jamvanderloeff/RGB-to-NTSC/README.md

# RGB-to-NTSC
 Converts RGB 15kHz video in the form of VGA or SCART into NTSC and/or PAL composite and s-video using
