jamvanderloeff/RGB-to-NTSC/rgbntsc.pdf

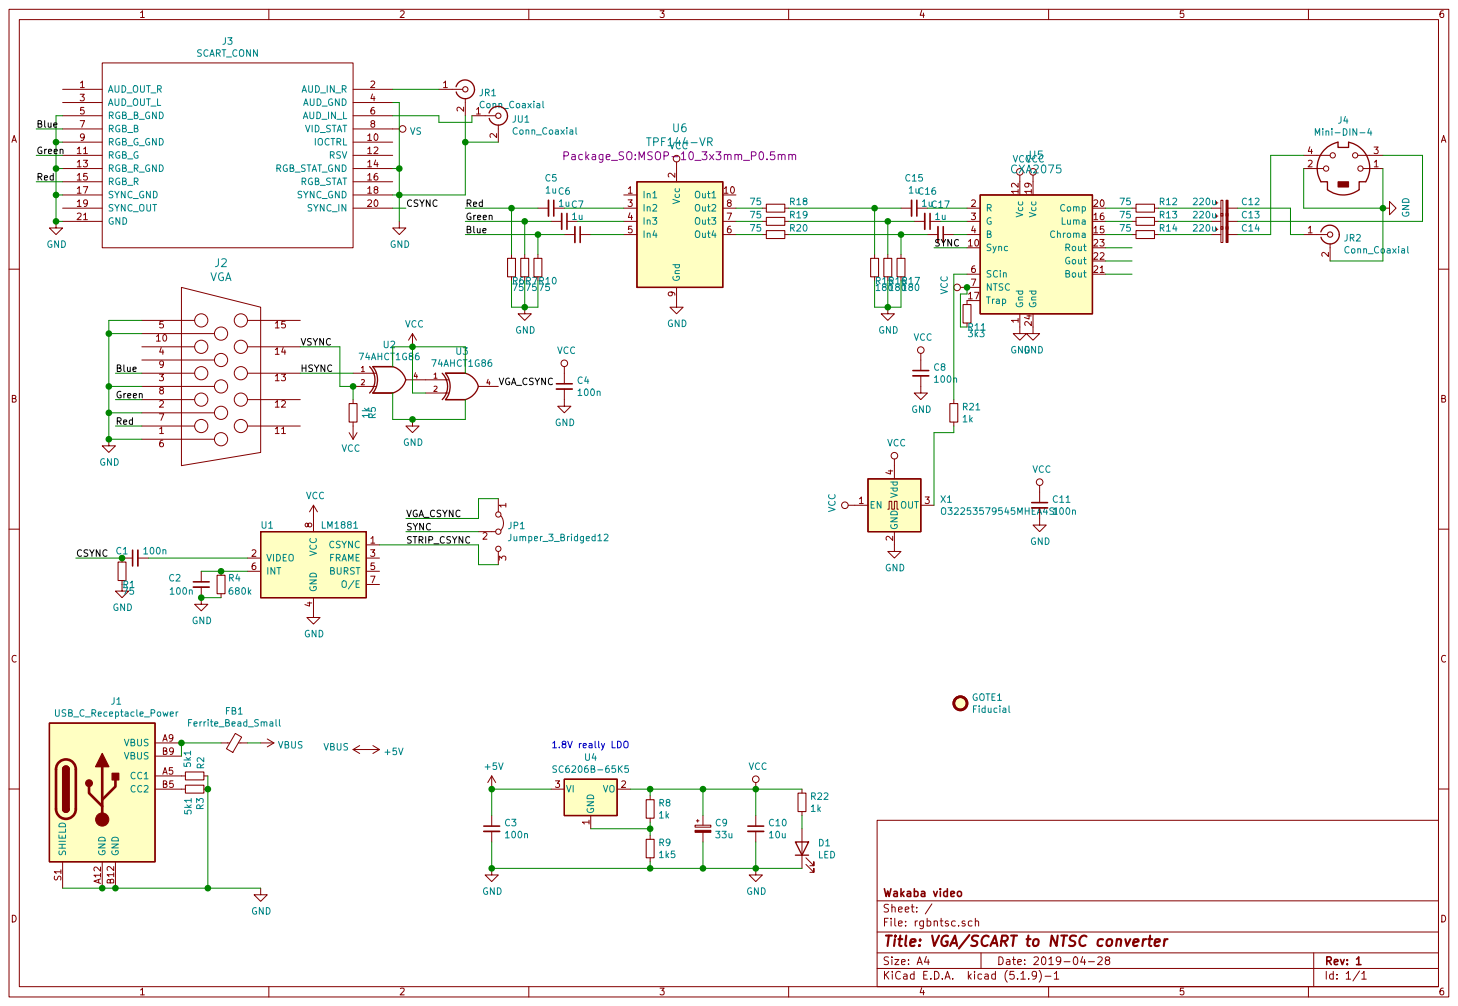
[picture p1: page 1]

File: rgbntsc.sch Sheet: / Wakaba video

Id: 1/1 Title: VGA/SCART to NTSC converter
