jamvanderloeff/RGB-to-NTSC/rgbntsc.kicad_pcb

## KiCad design rgbntsc.kicad_pcb (2025-10-04)

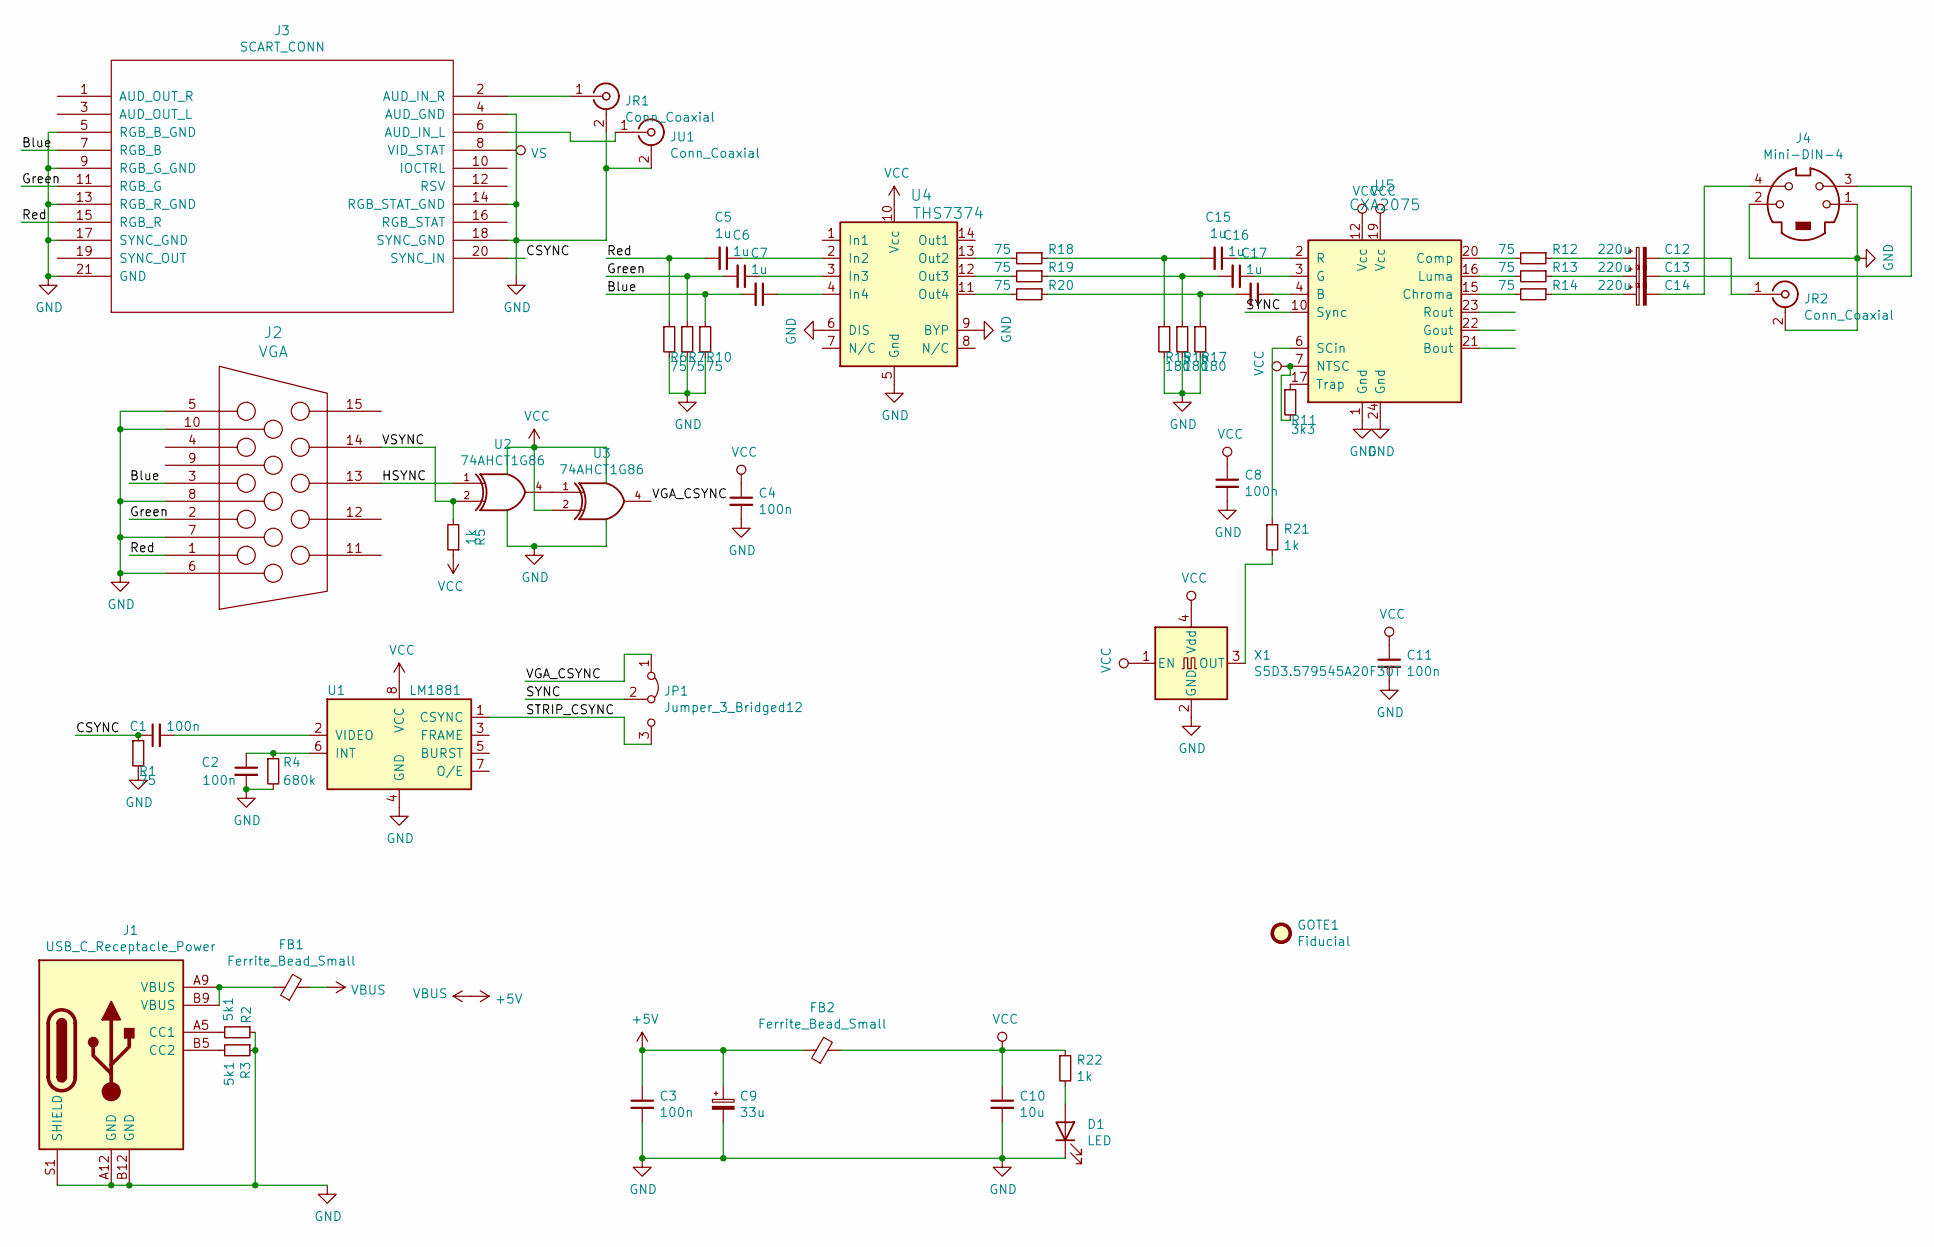
[picture p2: schematic rgbntsc.kicad_sch, VGA/SCART to NTSC converter]

Parts:
C1, C2, C3, C4, C8, C11: 100n; C_0805_2012Metric; LCSC C49678
C5, C6, C7, C15, C16, C17: 1u; C_0805_2012Metric; LCSC C28323
C9: 33u; CP_Elec_6.3x7.7; LCSC C127970
C10: 10u; C_0805_2012Metric; LCSC C15850
C12, C13, C14: 220u; CP_Elec_6.3x5.4; LCSC NOT FITTED
D1: LED; LED_0805_2012Metric; LCSC C34499
FB1, FB2: Ferrite_Bead_Small; C_0805_2012Metric; LCSC C1017
GOTE1: Fiducial; uwuriel; LCSC NOT FITTED
J1: USB_C_Receptacle_Power; USB_C_Receptacle_Generic_Power_Only; LCSC NOT FITTED
J2: VGA; VGA_CONN; LCSC NOT FITTED
J3: SCART_CONN; LCSC NOT FITTED
J4: Mini-DIN-4; CUI_MD-40SM; LCSC NOT FITTED
JP1: Jumper_3_Bridged12; SolderJumper-3_P1.3mm_Bridged12_Pad1.0x1.5mm; LCSC NOT FITTED
JR1, JR2: Conn_Coaxial; Cheapo_RCA_single_edge; LCSC NOT FITTED
JU1: Conn_Coaxial; Cheapo_RCA_single_edge; LCSC NOT FITTED
R1, R6, R7, R10, R12, R13, R14, R18, R19, R20: 75; R_0805_2012Metric; LCSC C20638
R2, R3: 5k1; R_0805_2012Metric; LCSC C27834
R4: 680k; R_0805_2012Metric; LCSC C17797
R5, R21, R22: 1k; R_0805_2012Metric; LCSC C17513
R11: 3k3; R_0805_2012Metric; LCSC C26010
R15, R16, R17: 180; R_0805_2012Metric; LCSC C25270
U1: LM1881; SOIC-8_3.9x4.9mm_P1.27mm; LCSC NOT FITTED
U2, U3: 74AHCT1G86; SOT-23-5; LCSC C43417
U4: THS7374; TSSOP-14_4.4x5mm_P0.65mm
U5: CXA2075; SO-24_5.3x15mm_P1.27mm; LCSC NOT FITTED
X1: S5D3.579545A20F30T; Oscillator_SMD_EuroQuartz_XO53-4Pin_5.0x3.2mm; LCSC C387187

Connections:
+5V: C3.1, C9.1, FB1.2, FB2.1
/Blue: C7.2, J2.3 (BLUE), J3.7 (RGB_B), R10.1
/CSYNC: C1.1, J3.20 (SYNC_IN), R1.1
/Green: C6.2, J2.2 (GREEN), J3.11 (RGB_G), R7.1
/HSYNC: J2.13 (HSYNC), U2.1
/Red: C5.2, J2.1 (RED), J3.15 (RGB_R), R6.1
/STRIP_CSYNC: JP1.3 (B), U1.1 (CSYNC)
/SYNC: JP1.2 (C), U5.10 (Sync)
/VGA_CSYNC: JP1.1 (A), U3.4
/VSYNC: J2.14 (VSYNC), R5.2, U2.2
GND: C2.2, C3.2, C4.2, C8.2, C9.2, C10.2, C11.2, D1.1 (K), J1.A12 (GND), J1.B12 (GND), J1.S1 (SHIELD), J2.5 (GND_HSYNC), J2.6 (RED_RTN), J2.7 (GREEN_RTN), J2.8 (BLUE_RTN), J2.10 (GND_VSYNC), J3.4 (AUD_GND), J3.5 (RGB_B_GND), J3.9 (RGB_G_GND), J3.13 (RGB_R_GND), J3.14 (RGB_STAT_GND), J3.17 (SYNC_GND), J3.18 (SYNC_GND), J3.21 (GND), J4.1, J4.2, JR1.2 (Ext), JR2.2 (Ext), JU1.2 (Ext), R1.2, R2.1, R3.1, R4.2, R6.2, R7.2, R10.2, R15.2, R16.2, R17.2, U1.4 (GND), U2.3 (GND), U3.3 (GND), U4.5 (Gnd), U4.6 (DIS), U4.9 (BYP), U5.1 (Gnd), U5.24 (Gnd), X1.2 (GND)
unnamed: C12.1, R12.1
unnamed: C13.1, R13.1
unnamed: C13.2, J4.3
unnamed: C14.1, R14.1
unnamed: C14.2, J4.4
unnamed: C15.2, R15.1, R18.1
unnamed: C16.2, R16.1, R19.1
unnamed: C17.2, R17.1, R20.1
unnamed: D1.2 (A), R22.2
unnamed: FB1.1, J1.A9 (VBUS), J1.B9 (VBUS)
unnamed: J1.A5 (CC1), R2.2
unnamed: J1.B5 (CC2), R3.2
unnamed: J3.6 (AUD_IN_L), JU1.1 (In)
unnamed: J3.2 (AUD_IN_R), JR1.1 (In)
unnamed: C12.2, JR2.1 (In)
unnamed: C2.1, R4.1, U1.6 (INT)
unnamed: C1.2, U1.2 (VIDEO)
unnamed: U2.4, U3.1
unnamed: C5.1, U4.2 (In2)
unnamed: C6.1, U4.3 (In3)
unnamed: C7.1, U4.4 (In4)
unnamed: R18.2, U4.13 (Out2)
unnamed: R19.2, U4.12 (Out3)
unnamed: R20.2, U4.11 (Out4)
unnamed: C17.1, U5.4 (B)
unnamed: R14.2, U5.15 (Chroma)
unnamed: R12.2, U5.20 (Comp)
unnamed: C16.1, U5.3 (G)
unnamed: R13.2, U5.16 (Luma)
unnamed: C15.1, U5.2 (R)
unnamed: R21.1, U5.6 (SCin)
unnamed: R11.1, U5.17 (Trap)
unnamed: R21.2, X1.3 (OUT)
VCC: C4.1, C8.1, C10.1, C11.1, FB2.2, R5.1, R11.2, R22.1, U1.8 (VCC), U2.5 (VCC), U3.2, U3.5 (VCC), U4.10 (Vcc), U5.7 (NTSC), U5.12 (Vcc), U5.19 (Vcc), X1.1 (EN), X1.4 (Vdd)
VS: J3.8 (VID_STAT)

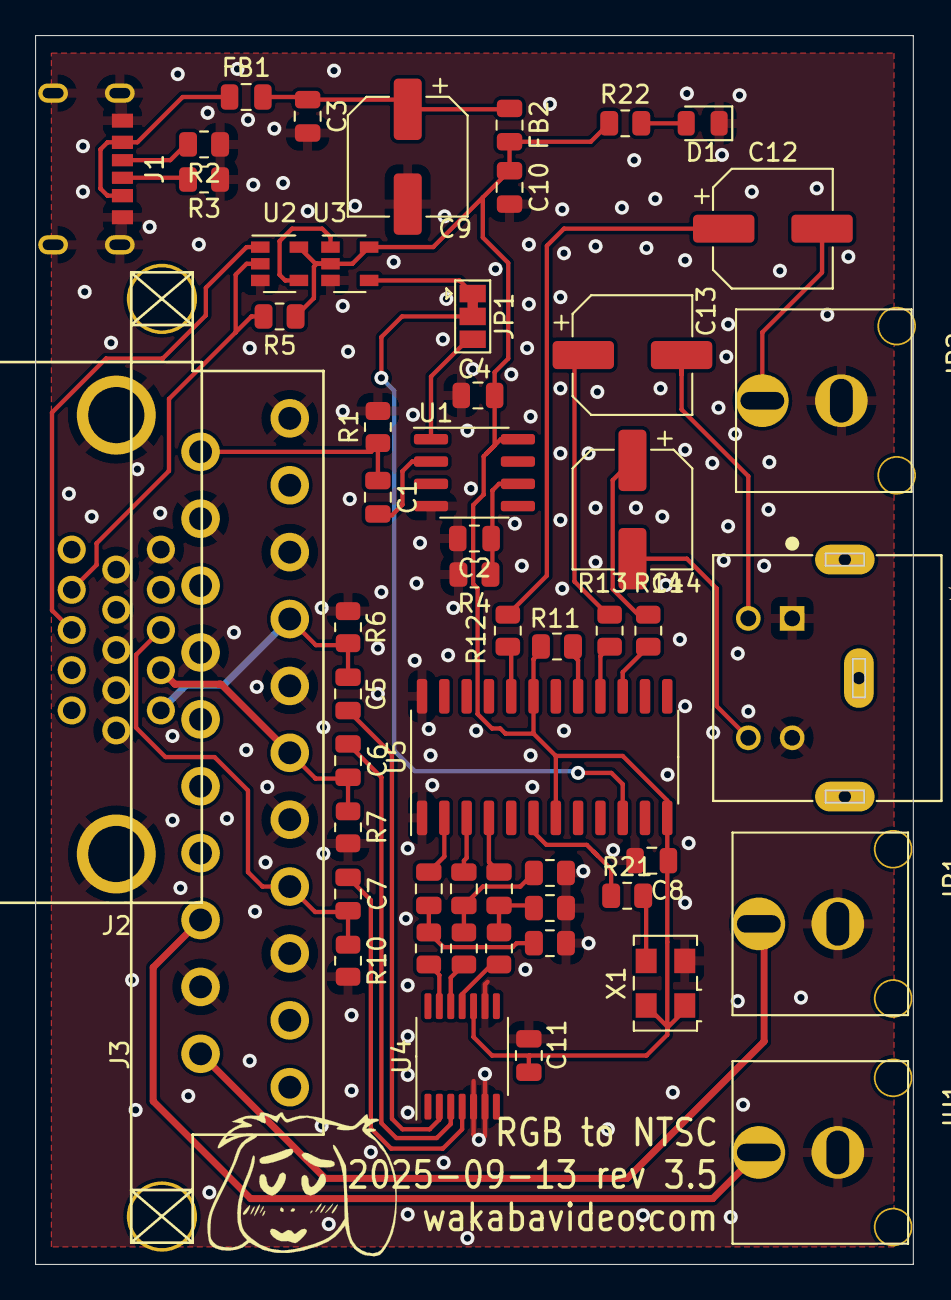
[picture p3: board rgbntsc.kicad_pcb from above]

Board: 2 copper layers, 50.0 x 70.0 mm, 55 parts (0 on the bottom side), 45 nets.
