jamvanderloeff/RGB-to-NTSC/(commit log)

2020-08-23 bit of cleanup and on github now woo
    [covers.kicad_pcb, rgbntsc.kicad_pcb, rgbntsc.sch]
2020-08-23 cleanup and pdfs/gerbs
    [rgbntsc-B_Cu.gbr, rgbntsc-B_Mask.gbr, rgbntsc-B_Paste.gbr, rgbntsc-B_SilkS.gbr, rgbntsc-Edge_Cuts.gbr, rgbntsc-F_Cu.gbr, rgbntsc-F_Mask.gbr, rgbntsc-F_Paste.gbr]
2020-11-21 CXA2075
    Replaces AD724 with CXA2075, also adds GBS compatible RGB out header
    [rgbntsc-B_Cu.gbr, rgbntsc-B_Mask.gbr, rgbntsc-B_Paste.gbr, rgbntsc-B_SilkS.gbr, rgbntsc-Edge_Cuts.gbr, rgbntsc-F_Cu.gbr, rgbntsc-F_Mask.gbr, rgbntsc-F_Paste.gbr]
2020-12-19 added 1v amp and output caps
    [rgbntsc-B_Cu.gbr, rgbntsc-B_Mask.gbr, rgbntsc-B_Paste.gbr, rgbntsc-B_SilkS.gbr, rgbntsc-Edge_Cuts.gbr, rgbntsc-F_Cu.gbr, rgbntsc-F_Mask.gbr, rgbntsc-F_Paste.gbr]
2020-12-28 corrected components
    [rgbntsc.kicad_pcb, rgbntsc.sch]
2021-06-18 add power LED, general tweakage
    [rgbntsc-B_Cu.gbr, rgbntsc-B_Mask.gbr, rgbntsc-B_Paste.gbr, rgbntsc-B_SilkS.gbr, rgbntsc-Edge_Cuts.gbr, rgbntsc-F_Cu.gbr, rgbntsc-F_Mask.gbr, rgbntsc-F_Paste.gbr]
2021-07-08 fix regulator resistor, add schematic pdf
    [rgbntsc.kicad_pcb, rgbntsc.sch]
2021-09-23 add cover
    [covers-B_Cu.gbr, covers-B_Mask.gbr, covers-B_SilkS.gbr, covers-Edge_Cuts.gbr, covers-F_Cu.gbr, covers-F_Mask.gbr, covers-F_SilkS.gbr, covers-NPTH.drl]
2021-11-15 ditched supply reg, just filter harder
    [rgbntsc.kicad_pcb, rgbntsc.sch]
2021-11-15 new gerbs
    [rgbntsc-B_Cu.gbr, rgbntsc-B_Mask.gbr, rgbntsc-B_Paste.gbr, rgbntsc-B_SilkS.gbr, rgbntsc-Edge_Cuts.gbr, rgbntsc-F_Cu.gbr, rgbntsc-F_Mask.gbr, rgbntsc-F_Paste.gbr]
2022-05-19 swapping parts
    [rgbntsc-B_Cu.gbr, rgbntsc-B_Mask.gbr, rgbntsc-B_Paste.gbr, rgbntsc-B_SilkS.gbr, rgbntsc-Edge_Cuts.gbr, rgbntsc-F_Cu.gbr, rgbntsc-F_Mask.gbr, rgbntsc-F_Paste.gbr]
2022-09-16 updated gerbs, kicad 6 migration
    [covers-B_Cu.gbr, covers-B_Mask.gbr, covers-B_Silkscreen.gbr, covers-Edge_Cuts.gbr, covers-F_Cu.gbr, covers-F_Mask.gbr, covers-F_Silkscreen.gbr, covers-NPTH.drl]
2024-08-17 resync git i forgor what changed
    [bom.csv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]
2025-01-22 prod file updates
    [BOM-rgbntsc.csv, bom.csv, designators.csv, positions.csv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]
2025-10-04 cover prod files
    [BOM-covers.csv, BOM-rgbntsc.csv, bom.csv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]
2025-10-05 prod files for cover plates
    [covers-B_Cu.gbr, covers-B_Mask.gbr, covers-B_Silkscreen.gbr, covers-Edge_Cuts.gbr, covers-F_Cu.gbr, covers-F_Mask.gbr, covers-F_Silkscreen.gbr, covers-NPTH.drl]
